shellshocker98/CSE453-Locker-Project/Locker STL files/LockerInterface.stl

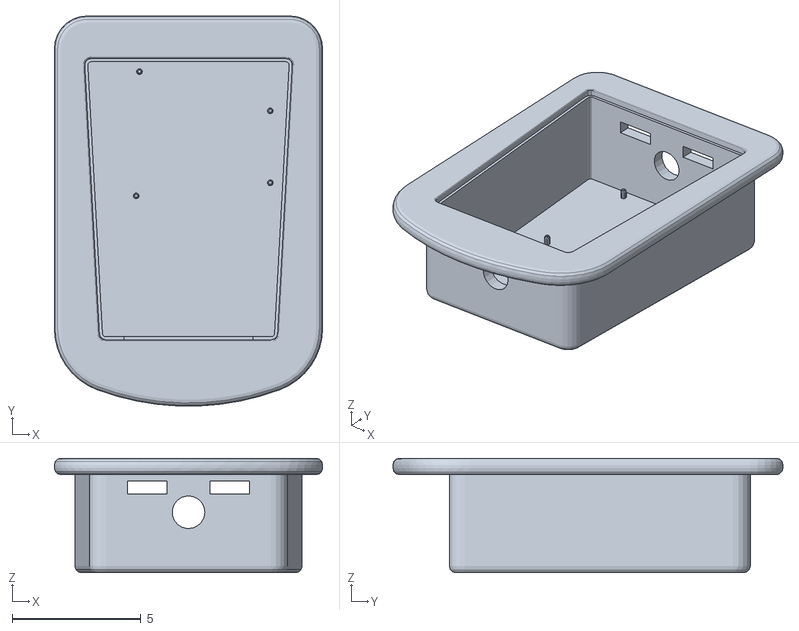
[picture p30: CAD file, 2019-05-18]
Locker STL files/LockerInterface.stl
10.4 x 15.1 x 4.45
