shellshocker98/CSE453-Locker-Project/Locker STL files/Opening Mechanism/LockGear.stl

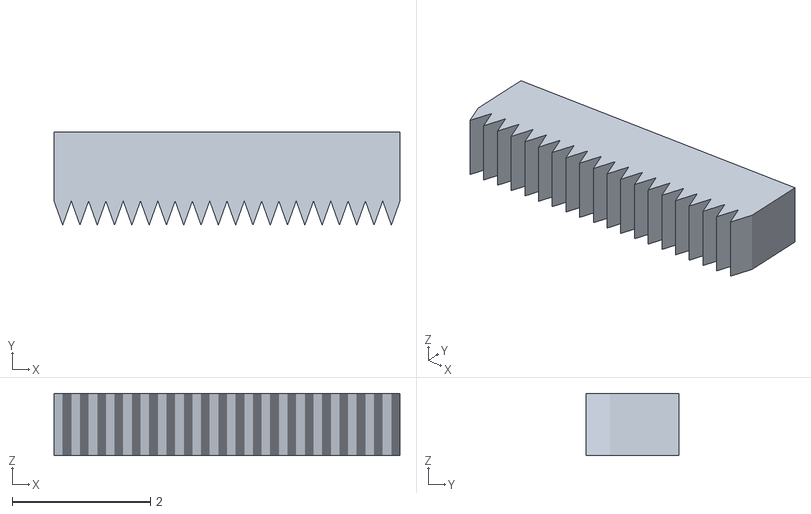
[picture p31: CAD file, 2019-05-18]
Locker STL files/Opening Mechanism/LockGear.stl
5.00 x 1.35 x 0.9
