shellshocker98/CSE453-Locker-Project/Locker STL files/Self Made Button/buttonHolder.stl

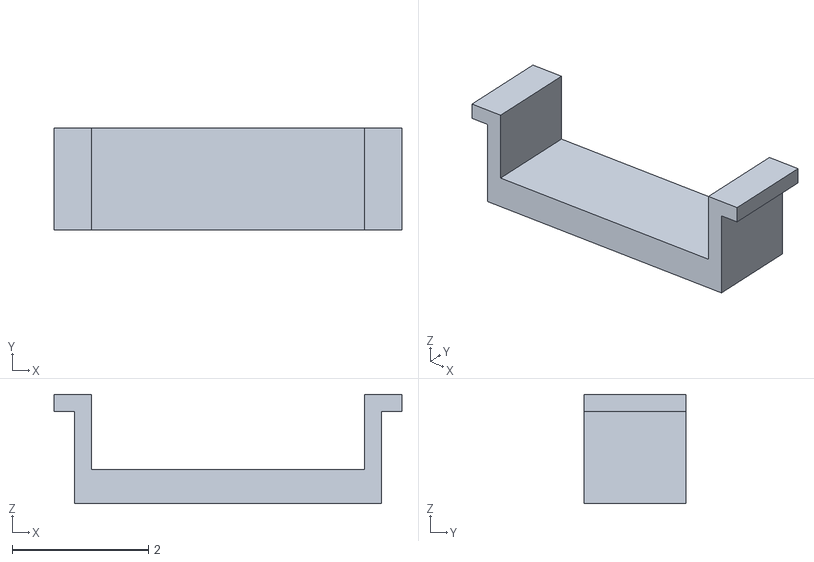
[picture p32: CAD file, 2019-05-18]
Locker STL files/Self Made Button/buttonHolder.stl
5.10 x 1.50 x 1.60
