shellshocker98/CSE453-Locker-Project/Locker STL files/LockSolenoidHolder.stl

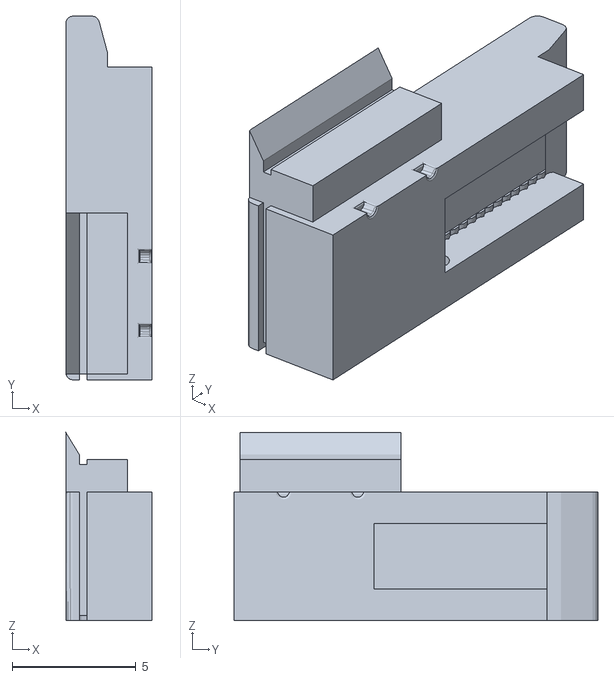
[picture p33: CAD file, 2019-05-18]
Locker STL files/LockSolenoidHolder.stl
3.49 x 14.7 x 7.60
