shellshocker98/CSE453-Locker-Project/Locker STL files/Opening Mechanism/KeyGear.stl

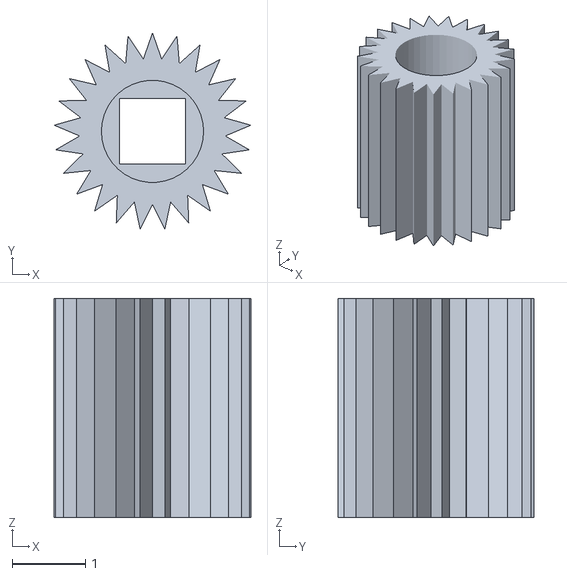
[picture p34: CAD file, 2019-05-18]
Locker STL files/Opening Mechanism/KeyGear.stl
2.69 x 2.69 x 3.00
