shellshocker98/CSE453-Locker-Project/Locker STL files/Self Made Button/button.stl

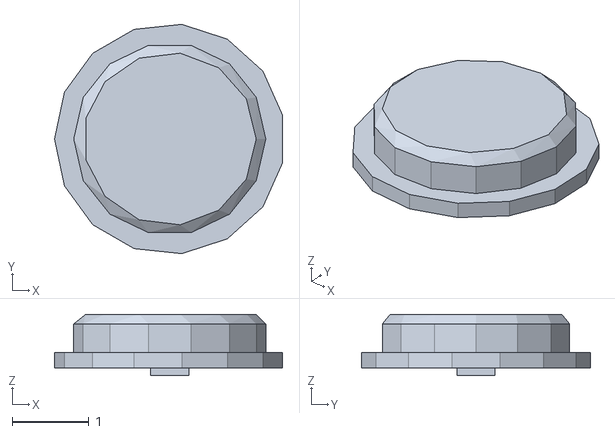
[picture p35: CAD file, 2019-05-18]
Locker STL files/Self Made Button/button.stl
2.97 x 2.98 x 0.8
