shellshocker98/CSE453-Locker-Project/Locker STL files/LockerInterfaceLid.stl

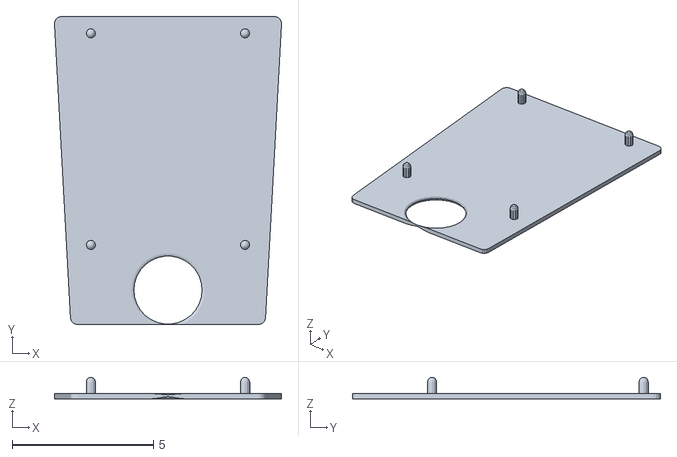
[picture p36: CAD file, 2019-05-18]
Locker STL files/LockerInterfaceLid.stl
8.04 x 10.9 x 0.762
