shellshocker98/CSE453-Locker-Project/Locker STL files/Opening Mechanism/FrontPlate.stl

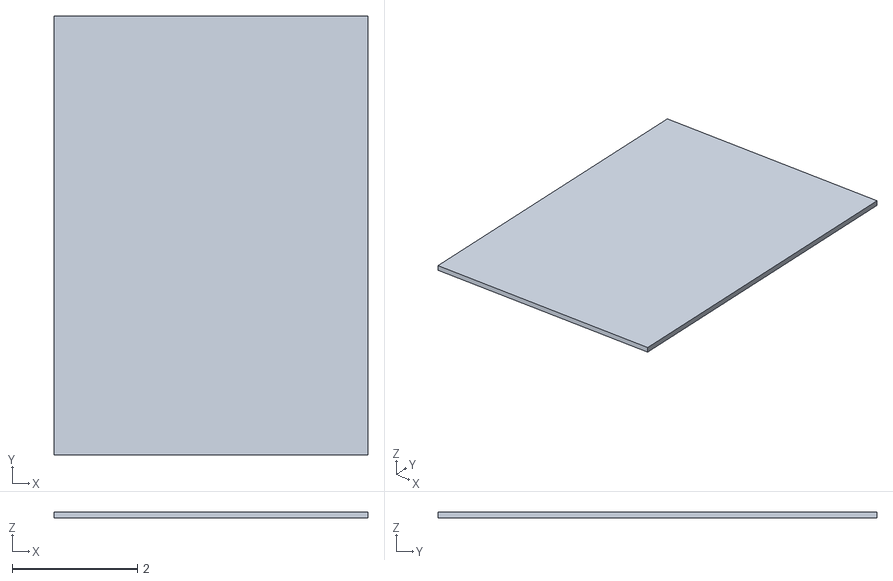
[picture p37: CAD file, 2019-05-18]
Locker STL files/Opening Mechanism/FrontPlate.stl
5.00 x 7.00 x 0.1
